ssalin/GBRL/README.MD

Documentation for Airquality platform can be found here

https://docs.google.com/document/d/1oFnARjLuFHp-5nVdnFOoGYGBi9iJlXXOtEU-Aas6cns/edit?usp=sharing
