ssalin/GBRL/PCB/Relay board/regulator_notes.txt

http://www.reuk.co.uk/wordpress/electric-circuit/lm317-voltage-calculator/

LM317T
R1= 270, R2 = 2.2k
