ssalin/GBRL/PCB/Relay board/layout.png

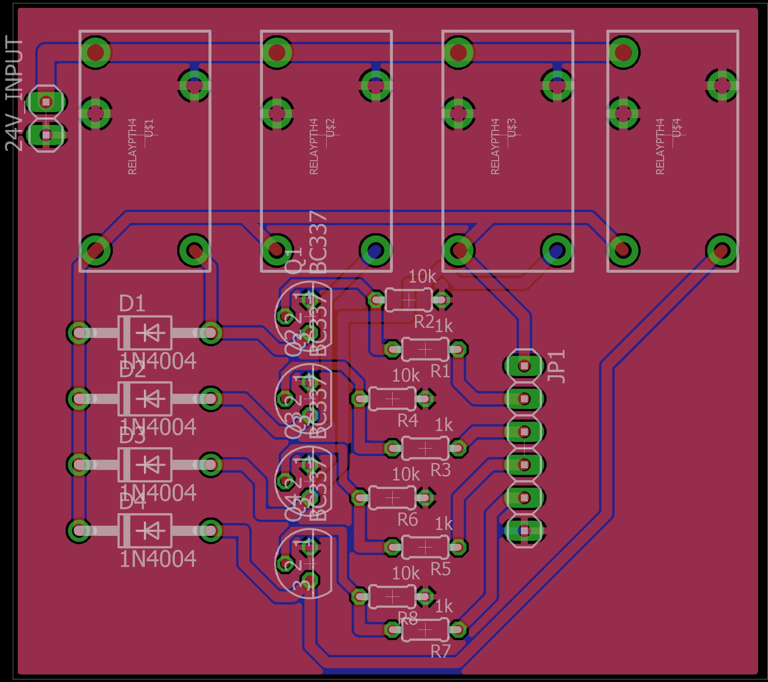
PCB/Relay board/layout.png
