ssalin/GBRL/PCB/Relay board/schem.png

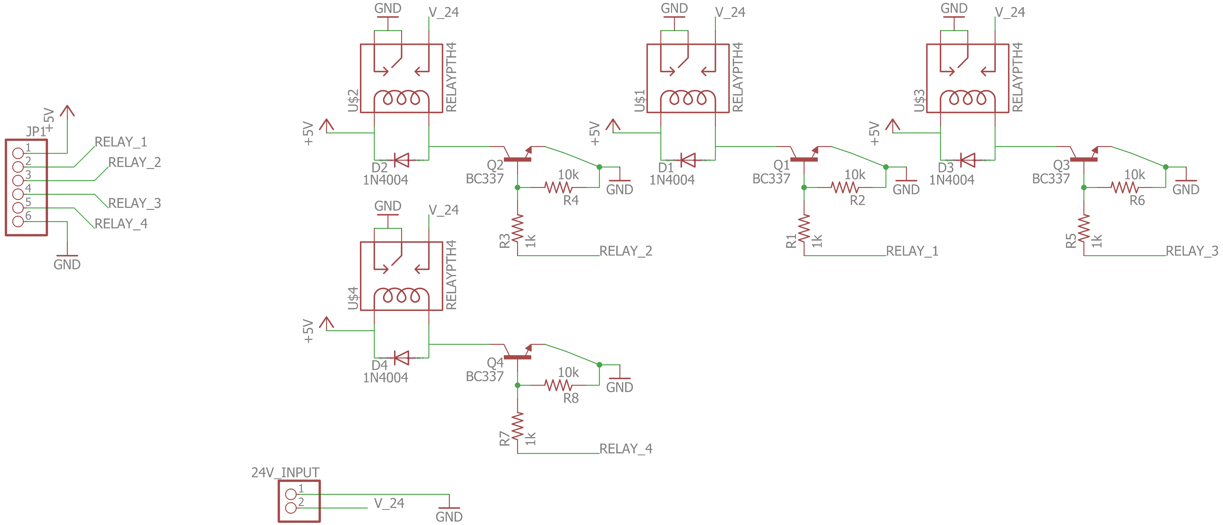
PCB/Relay board/schem.png
