ssalin/GBRL/PCB/Relay board/switch1.gif

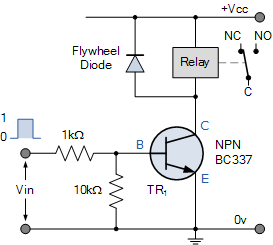
PCB/Relay board/switch1.gif
