ssalin/GBRL/PCB/Relay board/Swagelock controller.brd

## EAGLE design PCB/Relay board/Swagelock controller.brd (2017-07-12)

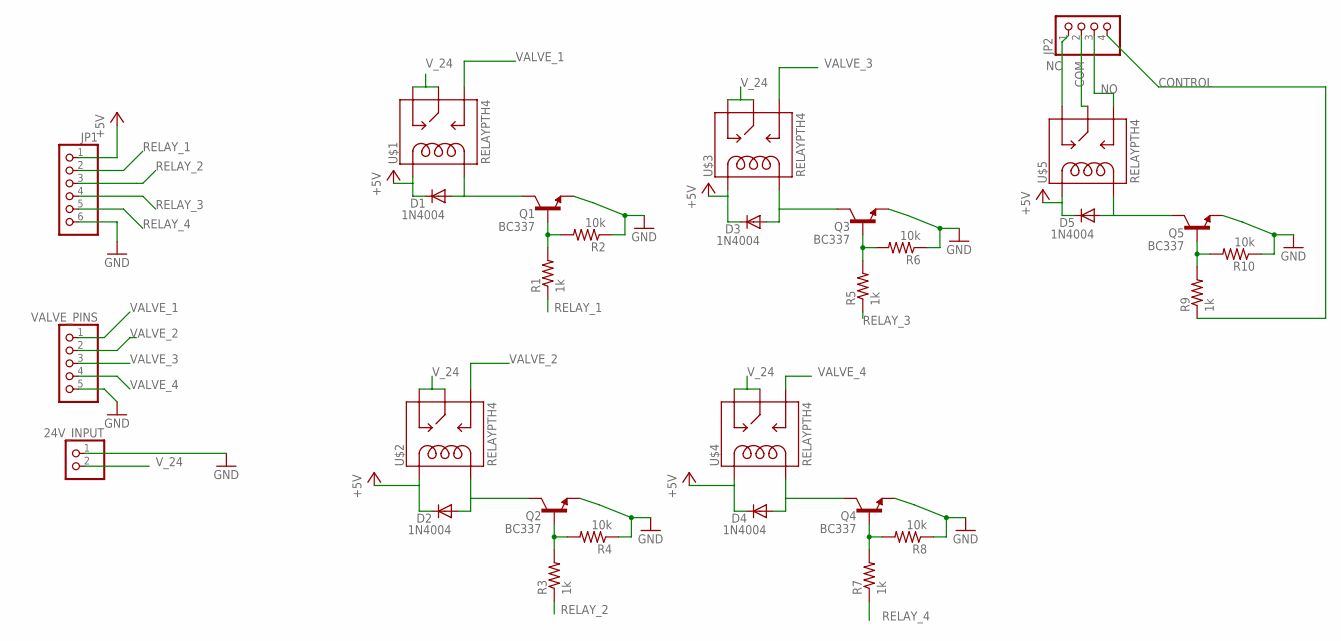
[picture p4: schematic Swagelock controller.sch, sheet 1]

Parts:
24V_INPUT: PINHD-1X2; 1X02
D1, D2, D3, D4, D5: 1N4004; DO41-10
JP1: PINHD-1X6; 1X06
JP2: PINHD-1X4; 1X04
Q1, Q2, Q3, Q4, Q5: BC337; TO92
R1, R3, R5, R7, R9: 1k; 0204/5
R2, R4, R6, R8, R10: 10k; 0204/5
U$1, U$2, U$3, U$4, U$5: RELAYPTH4; RELAY-JZC
VALVE_PINS: PINHD-1X5; 1X05

Connections:
+5V: D1.C, D2.C, D3.C, D4.C, D5.C, JP1.1, U$1.5 (COIL1), U$2.5 (COIL1), U$3.5 (COIL1), U$4.5 (COIL1), U$5.5 (COIL1)
COM: JP2.2, U$5.4 (MAIN)
CONTROL: JP2.4, R9.1
GND: 24V_INPUT.1, JP1.6, Q1.1 (E), Q2.1 (E), Q3.1 (E), Q4.1 (E), Q5.1 (E), R2.1, R4.1, R6.1, R8.1, R10.1, VALVE_PINS.5
unnamed: Q1.2 (B), R1.2, R2.2
unnamed: D1.A, Q1.3 (C), U$1.1 (COIL2)
unnamed: Q2.2 (B), R3.2, R4.2
unnamed: D2.A, Q2.3 (C), U$2.1 (COIL2)
unnamed: Q3.2 (B), R5.2, R6.2
unnamed: D3.A, Q3.3 (C), U$3.1 (COIL2)
unnamed: Q4.2 (B), R7.2, R8.2
unnamed: D4.A, Q4.3 (C), U$4.1 (COIL2)
unnamed: Q5.2 (B), R9.2, R10.2
unnamed: D5.A, Q5.3 (C), U$5.1 (COIL2)
NC: JP2.1, U$5.2 (NC)
NO: JP2.3, U$5.3 (NO)
RELAY_1: JP1.2, R1.1
RELAY_2: JP1.3, R3.1
RELAY_3: JP1.4, R5.1
RELAY_4: JP1.5, R7.1
VALVE_1: U$1.3 (NO), VALVE_PINS.1
VALVE_2: U$2.3 (NO), VALVE_PINS.2
VALVE_3: U$3.3 (NO), VALVE_PINS.3
VALVE_4: U$4.3 (NO), VALVE_PINS.4
V_24: 24V_INPUT.2, U$1.2 (NC), U$1.4 (MAIN), U$2.2 (NC), U$2.4 (MAIN), U$3.2 (NC), U$3.4 (MAIN), U$4.2 (NC), U$4.4 (MAIN)

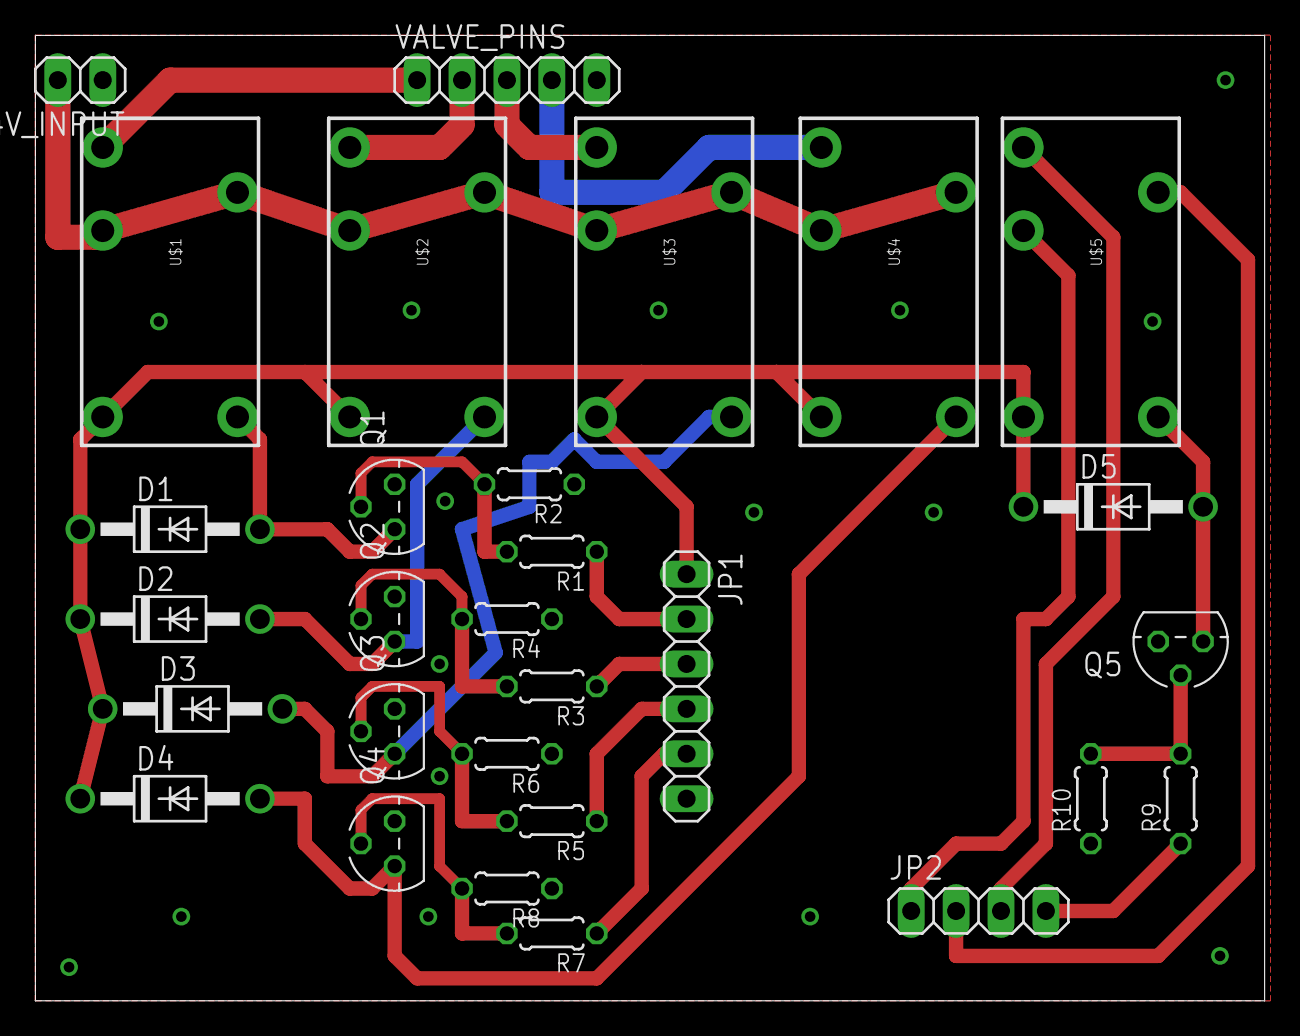
[picture p5: board Swagelock controller.brd from above]

Board: 2 copper layers, 69.5 x 54.6 mm, 29 parts (0 on the bottom side), 25 nets.
