ssalin/GBRL/(commit log)

2017-07-12 added layouts
    added layout and schematic for Swagelock valve controller & MimiV4
    [Mimi_layout.brd, Mimi_layout.sch, Mimi_layout_logo.brd, Mimi_layout_logo.sch, NCP1402_5V_step-up-v10.brd, NCP1402_5V_step-up-v10.sch, Swagelock controller.brd, Swagelock controller.sch]
2017-07-12 Updates, Valve controller
    Updated V1 to V2
    Added Swagelock control code
2017-07-12 Namechange
    to keep arduino software happy
2017-07-12 Functions
    sensor code more function-oriented and therefore more modular
2017-07-12 Datestamping
    Device should now log data with time/date information. code is also
    primed for IRQs
2017-09-06 Program used to debug standby mode
    I was having issues with the libraries that let the MKR1000 enter standby mode had to build this program with a blinking LED to figure out if IRQs were firing correctly / make them fire correctly. will move IRQ code to AQV3 tomorrow. net outcome: progress has been made on power consumption; hopefully this helps with overheating.
    [IRQSLEEPDEBUG.ino]
2017-09-07 Fixed Sleep (Sorta)
    Sleep kinda works now. for some reason the interrupts are getting triggered every minute or so - trying to figure out what's causing them to happen. Might need to clear alarm 2?
2017-09-14 Debugging
    still debugging sleep issues. moved function calls around to minimize the number of frames on the stack. program currently hangs when reconnecting to wifi the third time. not a full hang, just can't connect to the wifi.
2017-09-14 Timechange fix?
    Tried to fix an issue where the device would not wake up when the hour changed.
2017-09-26 bugfixes
    tried to add a way to reset the program if it get's deadlocked via alarm2. not sure if that is functioning but did make it so interrupts from the RTC are used to wait regardless of low power mode or not.
    [AQmonitorV4.ino]
2017-09-28 Add files via upload
    Switched to builtin LED to reduce external apparati needed for debugging.
    tried some timing changes but the double-posting doesnt seem to be effected.
2017-10-10 fixed IRQ never wakeup
    fixed a bug where the device would never get out of the IRQ wait loop. this also should fix the never-wake-up bug experienced in low power mode.
    [AQmonitorV4.ino]
2017-10-12 LP fix, API changes
    Lowpower mode seems to work without wifi enabled. changed the API to add a few parameters, changed naming, made order better
    [AQmonitorV4.ino]
2018-01-13 changed SPI speed
    Altering the SPI speed seems to have reduced the connectivity issues. now 10-20% of packets getting through
2018-01-13 updates & fixes
    added CO2 & SM50, better shinyei reading
    [TTN_OTAA_TEST2_BASE.ino, TTN_OTAA_TEST2_CO2_SM50.ino]
2018-01-18 Serial connection fix
    removed line causing code to wait for a serial connection, which was used to debug SPI speed problems
    [TTN_OTAA_TEST2_CO2_SM50.ino]
2018-01-18 Serial fix
    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
    [TTN_OTAA_TEST2_BASE.ino]
2018-02-12 added stable code for Dev1, Dev2
    doesn't send PM or CO, easy to fix via uncommenting if they are desired. stopped sending because readings were noise.
    [TTN_OTAA_DEV1_CO2_SM50.ino, TTN_OTAA_DEV2_CO2_SM50.ino]
2018-02-12 SD test program
    Program to make sure SD care is present and formatted correctly
    [CardInfo_TEST.ino]
2018-02-12 Ozone Converter
    Program to convert 3.3v logic level ADC readings to an ozone concentration based on the SM50 devices in the lab
